Sakura-IT/AMIV/README.md

# AMIV
Amiga A520 video adapter replacement with HDMI output
For more information see http://www.staringlizard.com/2015/09/14/amiv-3
