Sakura-IT/AMIV/board/3.1/README.txt

TMDS (HDMI) pair should be routed as 100 Ohms impedance to ground !
TMDS (USB) pair should be routed as 90 Ohms impedance to ground !
