Sakura-IT/AMIV/board/2.0/README.txt

TMDS pair should be routed as 100 Ohms (impedance) to ground !
