Sakura-IT/AMIV/board/3.1/schematics.png

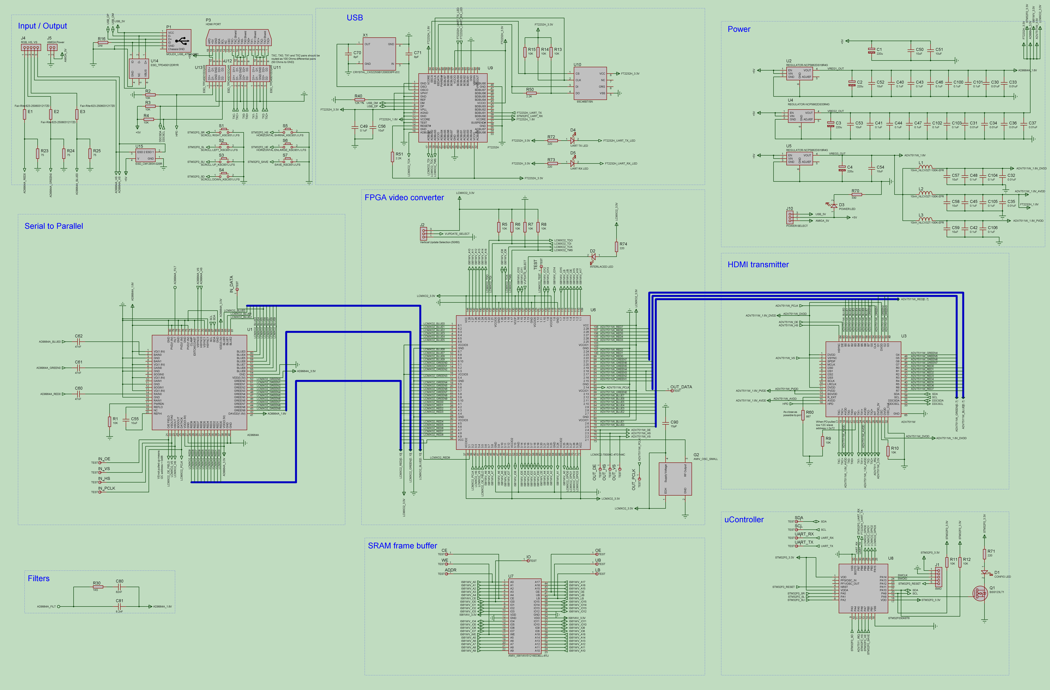
board/3.1/schematics.png
