Sakura-IT/AMIV/board/3.1/schematics.pdf

E1 | E2 | E3

R23

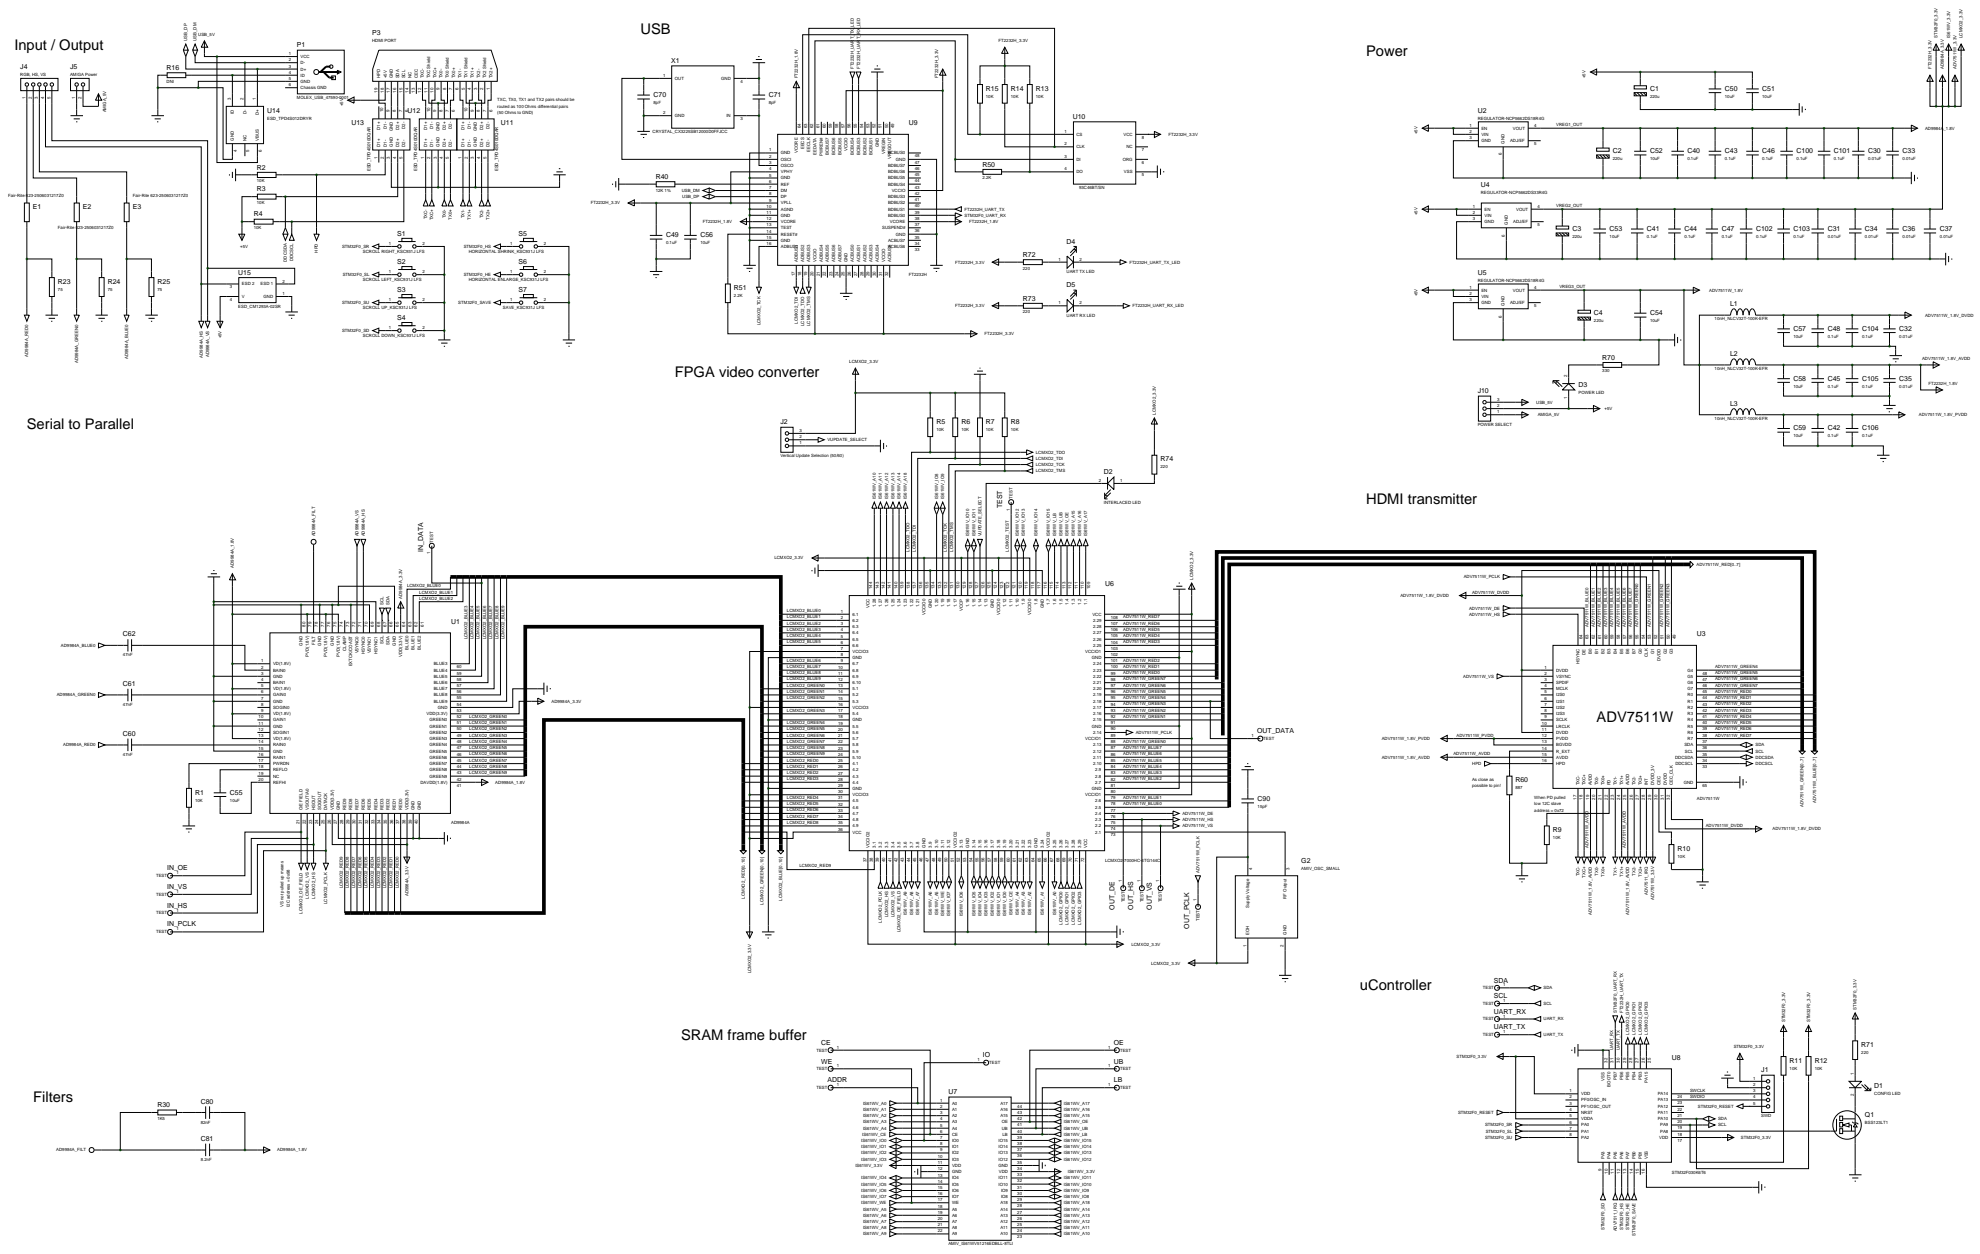
[picture p2: page 1]

HDMI PORT SCL SDA

TXC, TX0, TX1 and TX2 pairs should be
routed as 100 Ohms differential pairs
(50 Ohms to GND)

VS not pulled up means
