Sakura-IT/AMIV/mcu/amiv_main.h

#ifndef __AMIV_MAIN_INC_GUARD
#define __AMIV_MAIN_INC_GUARD

#include <stdint.h>

#include "stm32f0xx_rcc.h"
#include <stdarg.h>

#define NULL	(const int *)0
#define true	1
#define false	0

typedef unsigned char bool;

#endif
