Sakura-IT/AMIV/mcu/amiv_adv7511.h

#ifndef __AMIV_ADV7511_INC_GUARD_H
#define __AMIV_ADV7511_INC_GUARD_H

#include <stdint.h>

#define AMIV_ADV7511_REG_POWER_1					0x41
#define AMIV_ADV7511_REG_POWER_2					0xA1
#define AMIV_ADV7511_REG_INIT_1						0x98
#define AMIV_ADV7511_REG_INIT_2						0x9A
#define AMIV_ADV7511_REG_INIT_3						0x9C
#define AMIV_ADV7511_REG_INIT_4						0x9D
#define AMIV_ADV7511_REG_INIT_5						0xA2
#define AMIV_ADV7511_REG_INIT_6						0xA3
#define AMIV_ADV7511_REG_INIT_7						0xE0
#define AMIV_ADV7511_REG_INIT_8						0xF9
#define AMIV_ADV7511_REG_INIT_9						0xA5
#define AMIV_ADV7511_REG_INIT_10					0xAB

#define AMIV_ADV7511_REG_VIDEO_1					0x15
#define AMIV_ADV7511_REG_VIDEO_2					0x16
#define AMIV_ADV7511_REG_VIDEO_3					0x17
#define AMIV_ADV7511_REG_VIDEO_4					0x18
#define AMIV_ADV7511_REG_VIDEO_5					0xAF
#define AMIV_ADV7511_REG_VIDEO_6					0x40
#define AMIV_ADV7511_REG_VIDEO_7					0xD0

#define AMIV_ADV7511_REG_CLK_1						0xBA
#define AMIV_ADV7511_REG_CLK_2						0xDE

#define AMIV_ADV7511_REG_DETECT						0x42

#define AMIV_ADV7511_REG_AVI_1						0x56

#define AMIV_ADV7511_REG_IRQ						0x96
#define AMIV_ADV7511_REG_STATUS						0xC8

#define AMIV_ADV7511_ERROR_BAD_RECEIVER_BKSV		0x01
#define AMIV_ADV7511_ERROR_RI_MISMATCH				0x02
#define AMIV_ADV7511_ERROR_PJ_MISMATCH				0x03
#define AMIV_ADV7511_ERROR_I2C						0x04
#define AMIV_ADV7511_ERROR_REPEATER_TIMED_OUT		0x05
#define AMIV_ADV7511_ERROR_REPEATERS_EXCEEDED		0x06
#define AMIV_ADV7511_ERROR_HASH_CHECK_FAILED		0x07
#define AMIV_ADV7511_ERROR_TOO_MANY_DEVICES			0x08


void AMIV_ADV7511_Init();
void AMIV_ADV7511_PowerUp();
void AMIV_ADV7511_Config();
void AMIV_ADV7511_ReadEDID();
uint8_t *AMIV_ADV7511_GetEDIDPointer();
void AMIV_ADV7511_IncreaseVerticalSize(uint32_t factor);
void AMIV_ADV7511_DecreaseVerticalSize(uint32_t factor);

#endif
