Sakura-IT/AMIV/mcu/amiv_config.c

#include "stm32f0xx_gpio.h"
#include "amiv_main.h"
#include "amiv_config.h"

void AMIV_CONFIG_Init()
{
	GPIO_InitTypeDef GPIO_InitStructure;
}

void AMIV_CONFIG_I2C()
{
	GPIO_InitTypeDef GPIO_InitStructure;

	GPIO_PinAFConfig(GPIOA, GPIO_PinSource9, GPIO_AF_4);
	GPIO_PinAFConfig(GPIOA, GPIO_PinSource10, GPIO_AF_4);
	GPIO_InitStructure.GPIO_Pin = GPIO_Pin_9 | GPIO_Pin_10;
	GPIO_InitStructure.GPIO_Speed = GPIO_Speed_2MHz;
	GPIO_InitStructure.GPIO_Mode = GPIO_Mode_AF;
	GPIO_InitStructure.GPIO_PuPd = GPIO_PuPd_UP;
	GPIO_InitStructure.GPIO_OType = GPIO_OType_OD;
	GPIO_Init(GPIOA, &GPIO_InitStructure);
}

void AMIV_CONFIG_UART()
{
	GPIO_InitTypeDef GPIO_InitStructure;

	GPIO_PinAFConfig(GPIOB, GPIO_PinSource6, GPIO_AF_0);
	GPIO_PinAFConfig(GPIOB, GPIO_PinSource7, GPIO_AF_0);
	GPIO_InitStructure.GPIO_Pin =  GPIO_Pin_6 | GPIO_Pin_7;
	GPIO_InitStructure.GPIO_Speed = GPIO_Speed_50MHz;
	GPIO_InitStructure.GPIO_Mode = GPIO_Mode_AF;
	GPIO_InitStructure.GPIO_OType = GPIO_OType_PP;
	GPIO_InitStructure.GPIO_PuPd = GPIO_PuPd_UP;
	GPIO_Init(GPIOB, &GPIO_InitStructure);
}

void AMIV_CONFIG_GPIO()
{
	GPIO_InitTypeDef GPIO_InitStructure;

	GPIO_InitStructure.GPIO_Pin = GPIO_Pin_0 | GPIO_Pin_1;
	GPIO_InitStructure.GPIO_Mode = GPIO_Mode_IN;
	GPIO_InitStructure.GPIO_OType = GPIO_OType_PP;
	GPIO_InitStructure.GPIO_PuPd = GPIO_PuPd_UP;
	GPIO_InitStructure.GPIO_Speed = GPIO_Speed_Level_2;
	GPIO_Init(GPIOB, &GPIO_InitStructure);

	GPIO_InitStructure.GPIO_Pin = GPIO_Pin_0 | GPIO_Pin_1 | GPIO_Pin_2 | GPIO_Pin_3 | GPIO_Pin_6 | GPIO_Pin_7;
	GPIO_InitStructure.GPIO_Mode = GPIO_Mode_IN;
	GPIO_InitStructure.GPIO_OType = GPIO_OType_PP;
	GPIO_InitStructure.GPIO_PuPd = GPIO_PuPd_UP;
	GPIO_InitStructure.GPIO_Speed = GPIO_Speed_Level_2;
	GPIO_Init(GPIOA, &GPIO_InitStructure);

	GPIO_InitStructure.GPIO_Pin = GPIO_Pin_5 | GPIO_Pin_4 | GPIO_Pin_3;
	GPIO_InitStructure.GPIO_Mode = GPIO_Mode_OUT;
	GPIO_InitStructure.GPIO_OType = GPIO_OType_PP;
	GPIO_InitStructure.GPIO_PuPd = GPIO_PuPd_UP;
	GPIO_InitStructure.GPIO_Speed = GPIO_Speed_Level_2;
	GPIO_Init(GPIOB, &GPIO_InitStructure);

	GPIO_InitStructure.GPIO_Pin = GPIO_Pin_15;
	GPIO_InitStructure.GPIO_Mode = GPIO_Mode_OUT;
	GPIO_InitStructure.GPIO_OType = GPIO_OType_PP;
	GPIO_InitStructure.GPIO_PuPd = GPIO_PuPd_UP;
	GPIO_InitStructure.GPIO_Speed = GPIO_Speed_Level_2;
	GPIO_Init(GPIOA, &GPIO_InitStructure);
}

void AMIV_CONFIG_LED()
{
	GPIO_InitTypeDef GPIO_InitStructure;

	GPIO_InitStructure.GPIO_Pin = GPIO_Pin_8;
	GPIO_InitStructure.GPIO_Mode = GPIO_Mode_OUT;
	GPIO_InitStructure.GPIO_OType = GPIO_OType_PP;
	GPIO_InitStructure.GPIO_PuPd = GPIO_PuPd_UP;
	GPIO_InitStructure.GPIO_Speed = GPIO_Speed_Level_2;
	GPIO_Init(GPIOA, &GPIO_InitStructure);
}
