Sakura-IT/AMIV/mcu/amiv_config.h

#ifndef __AMIV_CONFIG_INC_GUARD
#define __AMIV_CONFIG_INC_GUARD

#include <stdint.h>

void AMIV_CONFIG_Init();
void AMIV_CONFIG_I2C();
void AMIV_CONFIG_UART();
void AMIV_CONFIG_GPIO();
void AMIV_CONFIG_LED();

#endif
