Sakura-IT/AMIV/(commit log)

2015-07-10 Added schematic files, updated fpga to output 50Hz and some minor configurations for mcu
2015-07-26 Renamed board versions
2015-07-26 Added 3d model for Amiv 2.0 board
2015-07-26 Added board name and version text onto PCB
2015-07-26 Corrected incorrect capacitance values for analog RGB inputs
2015-07-27 Let chassis ground for USB connector be unconnected as recommended by FTDI
2015-07-27 Added ground plane following analogue input signals
2015-07-27 Added part name for LED in schematics
2015-11-25 Updated design
    * New buttons (KSC931J LFS)
    * New leds (standard T/H)
    * Added more vias to ground
    * Improved power distribution
    * Improved grounding
2015-11-25 Added ground between TMDS pair
2015-11-30 Changed design of power rails for adv7511w
    The power for adv7511w is now divided into three different
    sections. Each one is filtered with separate inductor and
    capacitance. This is more like the reference layouts from
    Analog Devices.
2015-12-03 Added some extra caps for all power rails
